icl-rocketry/daq-hardware/BOM DAQ.xlsx

Id | Designator | Package | Quantity | Designation | Digikey Part Nr | Unit Pricing | url | Total Price
1 | C32,C13,C11,C1,C10,C7 | C_0603_1608Metric | 6 | 100n | 1276-1000-1-ND | £0.02 | https://www.digikey.com/product-detail/en/samsung-electro-mechanics/CL10B104KB8NNNC/1276-1000-1-ND/3889086 | £0.12
2 | J40,J39,J18,J17,J16 | JST_XH_B3B-XH-A_1x03_P2.50mm_Vertical | 5 | Conn_01x03 | 455-2248-ND | £0.15 | https://www.digikey.com/product-detail/en/jst-sales-america-inc/B3B-XH-A-LF-SN/455-2248-ND/1651046 | £0.75
3 | R40,R38,R35,R33,R31,R3 | R_0603_1608Metric | 6 | 43k | 311-43.0KHRCT-ND | £0.10 | https://www.digikey.com/product-detail/en/yageo/RC0603FR-0743KL/311-43.0KHRCT-ND/730180 | £0.60
4 | R39,R37,R34,R32,R30,R2 | R_0603_1608Metric | 6 | 22k | A129704CT-ND | £0.10 | https://www.digikey.com/product-detail/en/te-connectivity-passive-product/CRGCQ0603F22K/A129704CT-ND/8577536 | £0.60
6 | D2,D1,D8,D3,D7 | LED_0603_1608Metric_Castellated | 3 | LED | SML-D12U1WT86CT-ND | £0.12 | https://www.digikey.co.uk/product-detail/en/rohm-semiconductor/SML-D12U1WT86/SML-D12U1WT86CT-ND/5843858 | £0.36
7 | R36,R29,R10,R9,R8,R7,R25 | R_0603_1608Metric | 7 | 470 | A129684CT-ND | £0.10 | https://www.digikey.com/product-detail/en/te-connectivity-passive-product/CRGCQ0603F470R/A129684CT-ND/8577516 | £0.70
9 | SW3 | SW_CuK_JS202011AQN_DPDT_Angled | 1 | SW_DPDT_x2 | 401-2000-ND | £0.43 | https://www.digikey.com/products/en?keywords=JS202011AQN | £0.43
10 | C31,C30,C29,C14,C12,C5,C4 | CP_Elec_4x5.4 | 7 | 10u | 399-14794-1-ND | £0.13 | https://www.digikey.co.uk/product-detail/en/kemet/EDK106M035A9BAA/399-14794-1-ND/7319832 | £0.88
12 | C27 | C_0603_1608Metric_Pad1.05x0.95mm_HandSolder | 1 | 220nF | 1276-1989-1-ND | £0.03 | https://www.digikey.co.uk/product-detail/en/tdk-corporation/C1608X7R1A224M/445-5133-1-ND/2093748 | £0.03
13 | R20,R19,R12,R15,R14,R13,R11,R28,R17,R5,R4 | R_0603_1608Metric | 11 | 10k | A129700CT-ND | £0.02 | https://www.digikey.com/product-detail/en/te-connectivity-passive-product/CRGCQ0603F10K/A129700CT-ND/8577532 | £0.26
14 | U4 | Texas_PowerVFQFN_15 | 1 | TPS63070 | 296-44874-1-ND | £2.08 | https://www.digikey.com/product-detail/en/texas-instruments/TPS63070RNMR/296-44874-1-ND/6217416 | £2.08
15 | R24 | R_0603_1608Metric | 1 | 150k | A129714CT-ND | £0.10 | https://www.digikey.com/product-detail/en/te-connectivity-passive-product/CRGCQ0603F150K/A129714CT-ND/8577546 | £0.10
16 | R23 | R_0603_1608Metric | 1 | 470k | A129720CT-ND | £0.10 | https://www.digikey.com/product-detail/en/te-connectivity-passive-product/CRGCQ0603F470K/A129720CT-ND/8577552 | £0.10
17 | U5 | Texas_PowerVFQFN_15 | 1 | TPS630701 | 296-47298-1-ND | £2.08 | https://www.digikey.com/product-detail/en/texas-instruments/TPS630701RNMR/296-47298-1-ND/7688308 | £2.08
18 | R22,R21 | R_0603_1608Metric | 2 | 100k | A129712CT-ND | £0.10 | https://www.digikey.com/product-detail/en/te-connectivity-passive-product/CRGCQ0603F100K/A129712CT-ND/8577544 | £0.20
19 | L3,L2 | L_Taiyo-Yuden_NR-30xx | 2 | 1u5 | 587-2617-1-ND | £0.41 | https://www.digikey.com/product-detail/en/taiyo-yuden/NR3015T1R5N/587-2617-1-ND/2349988 | £0.82
22 | R6,R1 | R_0603_1608Metric | 2 | 4k7 | A129696CT-ND | £0.02 | https://www.digikey.com/product-detail/en/te-connectivity-passive-product/CRGCQ0603F4K7/A129696CT-ND/8577528 | £0.05
24 | U12 | TSSOP-28_4.4x9.7mm_P0.65mm | 1 | PCA9685PW | 568-11925-1-ND | £1.81 | https://www.digikey.com/product-detail/en/nxp-usa-inc/PCA9685PW118/568-11925-1-ND/5221902 | £1.81
25 | U2 | ESP32-WROOM-32U | 1 | ESP32-WROOM-32D | 1904-1026-1-ND | £2.95 | https://www.digikey.com/product-detail/en/espressif-systems/ESP32-WROOM-32U/1904-1026-1-ND/9381735 | £2.95
26 | SW2,SW1 | SW_Push_1P1T_NO_CK_KMR2 | 2 | SW1 | 401-1426-1-ND | £0.40 | https://www.digikey.com/product-detail/en/c-k/K12SCS1.55NOLFTX/CKN10790CT-ND/7056072 | £0.80
29 | C3,C2 | C_0603_1608Metric | 2 | 1nF | 732-8001-1-ND | £0.01 | https://www.digikey.com/product-detail/en/w-rth-elektronik/885012206083/732-8001-1-ND/5454628 | £0.03
30 | D4,D6,D5 | D_SOD-123F | 3 | D_Schottky | 1655-1926-1-ND | £0.12 | https://www.digikey.co.uk/product-detail/en/smc-diode-solutions/DSS13UTR/1655-1926-1-ND/8341868 | £0.36
31 | Q3,Q2 | SOT-23 | 2 | PMV20ENR | 1727-2301-1-ND | £0.30 | https://www.digikey.com/products/en/discrete-semiconductor-products/transistors-fets-mosfets-single/278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 | £0.60
32 | C28 | C_0603_1608Metric | 1 | 2.2n | 732-8003-1-ND | £0.02 | https://www.digikey.com/product-detail/en/w-rth-elektronik/885012206085/732-8003-1-ND/5454630 | £0.02
33 | U13 | TSSOP-8_4.4x3mm_P0.65mm | 1 | TPS2412PW | 296-39371-1-ND | £2.24 | https://www.digikey.com/products/en/integrated-circuits-ics/pmic-or-controllers-ideal-diodes/758?k=TPS2412PW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 | £2.24
34 | J15 | BarrelJack_Wuerth_6941xx301002 | 1 | Barrel_Jack_Switch | 732-5930-ND | £0.80 | https://www.digikey.co.uk/product-detail/en/w-rth-elektronik/694106301002/732-5930-ND/5047522 | £0.80
35 | J1 | USB_B_OST_USB-B1HSxx_Horizontal | 1 | USB_B | ED2983-ND | £0.45 | https://www.digikey.co.uk/product-detail/en/on-shore-technology-inc/USB-B1HSB6/ED2983-ND/2677744 | £0.45
42 | C15,C19,C17,C21 | C_0603_1608Metric | 4 | 100nF | 1276-1000-1-ND | £0.02 | https://www.digikey.com/product-detail/en/samsung-electro-mechanics/CL10B104KB8NNNC/1276-1000-1-ND/3889086 | £0.08
43 | J2 | microSD_HC_Hirose_DM3AT-SF-PEJM5 | 1 | Micro_SD_Card_Det_Hirose_DM3AT | HR1964CT-ND | £2.08 | https://www.digikey.com/product-detail/en/hirose-electric-co-ltd/DM3AT-SF-PEJM5/HR1964CT-ND/2533566 | £2.08
44 | U1 | QFN-24-1EP_4x4mm_P0.5mm_EP2.6x2.6mm_ThermalVias | 1 | CP2102N-A01-GQFN24 | 336-4737-1-ND | £1.05 | https://www.digikey.com/products/en/integrated-circuits-ics/interface-controllers/753?k=CP2102N-A01-GQFN24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 | £1.05
45 | U11 | TSSOP-20_4.4x6.5mm_Pitch0.65mm | 1 | ADS131M04 | 296-ADS131M04IPWRCT-ND | £4.20 | https://www.digikey.co.uk/product-detail/en/texas-instruments/ADS131M04IPWR/296-ADS131M04IPWRCT-ND/10817002 | £4.20
46 | U3 | Texas_S-PWSON-N10_ThermalVias | 1 | TPS61093 | 296-39430-1-ND | £2.08 | https://www.digikey.com/product-detail/en/texas-instruments/TPS61093DSKR/296-39430-1-ND/5143378 | £2.08
47 | R18 | R_0603_1608Metric | 1 | 200k | P200KHCT-ND | £0.05 | https://www.digikey.com/product-detail/en/panasonic-electronic-components/ERJ-3EKF2003V/P200KHCT-ND/198241 | £0.05
48 | R16 | R_0603_1608Metric | 1 | 191k | P191KHCT-ND | £0.05 | https://www.digikey.com/product-detail/en/panasonic-electronic-components/ERJ-3EKF1913V/P191KHCT-ND/198216 | £0.05
49 | L1 | L_Taiyo-Yuden_NR-30xx | 1 | 10u | 587-1650-1-ND | £0.27 | https://www.digikey.com/product-detail/en/taiyo-yuden/NR3015T100M/587-1650-1-ND/1008265 | £0.27
50 | C26,C25,C24,C23,C22,C20,C18,C16 | C_0603_1608Metric | 8 | 10nF | 732-8007-1-ND | £0.02 | https://www.digikey.com/product-detail/en/w-rth-elektronik/885012206089/732-8007-1-ND/5454634 | £0.13
51 | C9,C8 | C_0603_1608Metric | 2 | 1u | 1276-1036-1-ND | £0.03 | https://www.digikey.com/product-detail/en/samsung-electro-mechanics/CL10A105KQ8NNNC/1276-1036-1-ND/3889122 | £0.05
52 | C6 | C_0603_1608Metric | 1 | 4u7 | 1276-1045-1-ND | £0.04 | https://www.digikey.com/product-detail/en/samsung-electro-mechanics/CL10A475KQ8NNNC/1276-1045-1-ND/3889131 | £0.04
53 | U10 | SMDIP-4_W9.53mm | 1 | LTV-817S | 160-1893-1-ND | £0.38 | https://www.digikey.com/product-detail/en/lite-on-inc/LTV-817S-TA1/160-1893-1-ND/3306757 | £0.38
54 | R27,R26 | R_0603_1608Metric | 2 | 500 | P499HCT-ND | £0.05 | https://www.digikey.com/product-detail/en/panasonic-electronic-components/ERJ-3EKF4990V/P499HCT-ND/198414 | £0.10
55 | J10,J9,J14,J13,J12,J11,J5,J6,J7,J8,J37,J36,J4 | TerminalBlock_Phoenix_MPT-0,5-2-2.54_1x02_P2.54mm_Horizontal | 13 | Screw_Terminal_01x02 | ED10561-ND | £0.44 | https://www.digikey.com/product-detail/en/on-shore-technology-inc/OSTVN02A150/ED10561-ND/1588862 | £5.75
57 | J3 | JST_PH_S2B-PH-K_1x02_P2.00mm_Horizontal | 1 | Conn_01x02 | 455-1719-ND | £0.13 | https://www.digikey.co.uk/product-detail/en/jst-sales-america-inc/S2B-PH-K-S-LF-SN/455-1719-ND/926626 | £0.13
58 | U9,U8,U7,U6 | SOIC-8_3.9x4.9mm_P1.27mm | 4 | MAX31855RASA | MAX31855RASA+TCT-ND | £4.06 | https://www.digikey.com/products/en/integrated-circuits-ics/interface-sensor-and-detector-interfaces/752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 | £16.24
59 | Q1 | SOT-363_SC-70-6 | 1 | MMDT2222A | MMDT2222A-FDICT-ND | £0.26 | https://www.digikey.com/product-detail/en/diodes-incorporated/MMDT2222A-7-F/MMDT2222A-FDICT-ND/717897 | £0.26
 |  |  |  |  |  |  |  | £53.15
 | notes:
 | qty when searching: 10 for capacitors, 1 for everything else
 | get cut tape, NOT reels
 | passives 0603imp and 1608 metric
 | if all else equal Samsung electro-mechanics >>
 | passives = resistors, capacitors
