icl-rocketry/daq-hardware/daq-hardware.kicad_pcb

## KiCad design daq-hardware.kicad_pcb (2019-11-12)

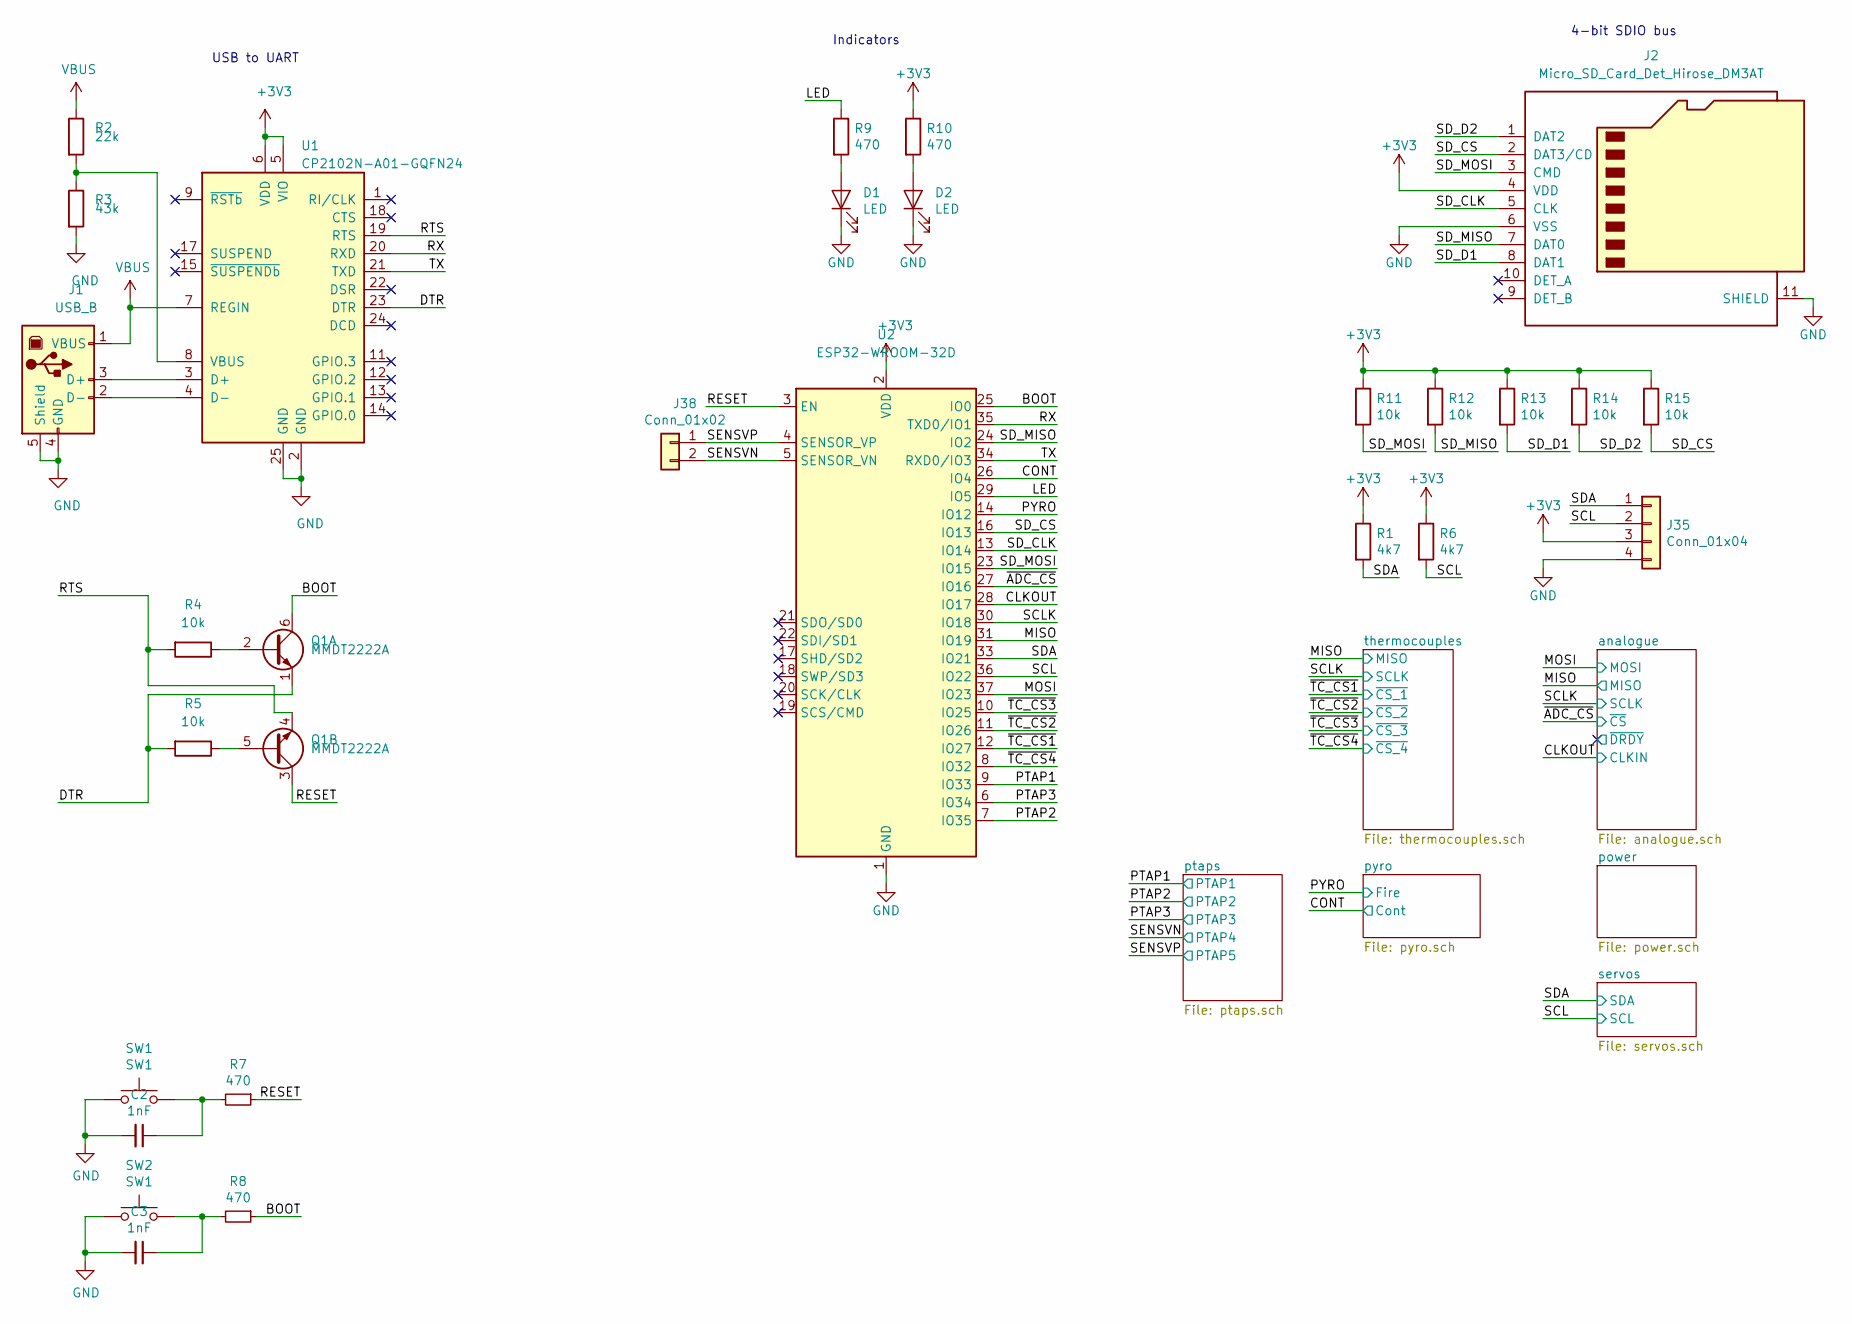
[picture p1: schematic daq-hardware.sch]

Parts:
C2, C3: 1nF; C_0603_1608Metric
D1, D2: LED; LED_0603_1608Metric_Castellated
J1: USB_B; USB_B_OST_USB-B1HSxx_Horizontal
J2: Micro_SD_Card_Det_Hirose_DM3AT; microSD_HC_Hirose_DM3AT-SF-PEJM5
J35: Conn_01x04; PinHeader_1x04_P2.54mm_Vertical
J38: Conn_01x02; PinHeader_1x02_P2.54mm_Vertical
Q1: MMDT2222A; SOT-363_SC-70-6
R1, R6: 4k7; R_0603_1608Metric
R2: 22k; R_0603_1608Metric
R3: 43k; R_0603_1608Metric
R4, R5, R11, R12, R13, R14, R15: 10k; R_0603_1608Metric
R7, R8, R9, R10: 470; R_0603_1608Metric
SW1, SW2: SW1; SW_Push_1P1T_NO_CK_KMR2
U1: CP2102N-A01-GQFN24; QFN-24-1EP_4x4mm_P0.5mm_EP2.6x2.6mm_ThermalVias
U2: ESP32-WROOM-32D; ESP32-WROOM-32U

Connections:
+3V3: J2.4 (VDD), J35.3, R1.1, R6.1, R10.1, R11.1, R12.1, R13.1, R14.1, R15.1, U1.5 (VIO), U1.6 (VDD), U2.2 (VDD); also elsewhere on the board
/BOOT: Q1.6 (C1), R8.1, U2.25 (IO0); also elsewhere on the board
/CLKOUT: U2.28 (IO17); also elsewhere on the board
/CONT: U2.26 (IO4); also elsewhere on the board
/DTR: Q1.1 (E1), R5.2, U1.23 (DTR)
/LED: R9.1, U2.29 (IO5); also elsewhere on the board
/MISO: U2.31 (IO19); also elsewhere on the board
/MOSI: U2.37 (IO23); also elsewhere on the board
/PTAP1: U2.9 (IO33); also elsewhere on the board
/PTAP2: U2.7 (IO35); also elsewhere on the board
/PTAP3: U2.6 (IO34); also elsewhere on the board
/PYRO: U2.14 (IO12); also elsewhere on the board
/RESET: Q1.3 (C2), R7.1, U2.3 (EN); also elsewhere on the board
/RTS: Q1.4 (E2), R4.2, U1.19 (RTS)
/RX: U1.20 (RXD), U2.35 (TXD0/IO1); also elsewhere on the board
/SCL: J35.2, R6.2, U2.36 (IO22); also elsewhere on the board
/SCLK: U2.30 (IO18); also elsewhere on the board
/SDA: J35.1, R1.2, U2.33 (IO21); also elsewhere on the board
/SD_CLK: J2.5 (CLK), U2.13 (IO14); also elsewhere on the board
/SD_CS: J2.2 (DAT3/CD), R15.2, U2.16 (IO13); also elsewhere on the board
/SD_D1: J2.8 (DAT1), R13.2
/SD_D2: J2.1 (DAT2), R14.2
/SD_MISO: J2.7 (DAT0), R12.2, U2.24 (IO2); also elsewhere on the board
/SD_MOSI: J2.3 (CMD), R11.2, U2.23 (IO15); also elsewhere on the board
/SENSVN: J38.2, U2.5 (SENSOR_VN); also elsewhere on the board
/SENSVP: J38.1, U2.4 (SENSOR_VP); also elsewhere on the board
/TX: U1.21 (TXD), U2.34 (RXD0/IO3); also elsewhere on the board
/~ADC_CS: U2.27 (IO16); also elsewhere on the board
/~TC_CS1: U2.12 (IO27); also elsewhere on the board
/~TC_CS2: U2.11 (IO26); also elsewhere on the board
/~TC_CS3: U2.10 (IO25); also elsewhere on the board
/~TC_CS4: U2.8 (IO32); also elsewhere on the board
GND: C2.2, C3.2, D1.1 (K), D2.1 (K), J1.4 (GND), J1.5 (Shield), J2.6 (VSS), J2.11 (SHIELD), J35.4, R3.2, SW1.1, SW2.1, U1.2 (GND), U1.25 (GND), U2.1 (GND), U2.15 (GND), U2.38 (GND); also elsewhere on the board
unnamed: C2.1, R7.2, SW1.2
unnamed: C3.1, R8.2, SW2.2
unnamed: D1.2 (A), R9.2
unnamed: D2.2 (A), R10.2
unnamed: J1.2 (D-), U1.4 (D-)
unnamed: J1.3 (D+), U1.3 (D+)
unnamed: Q1.2 (B1), R4.1
unnamed: Q1.5 (B2), R5.1
unnamed: R2.2, R3.1, U1.8 (VBUS)
unnamed 113: U2.17 (SHD/SD2); also elsewhere on the board
unnamed 114: U2.18 (SWP/SD3); also elsewhere on the board
unnamed 115: U2.19 (SCS/CMD); also elsewhere on the board
unnamed 116: U2.20 (SCK/CLK); also elsewhere on the board
unnamed 117: U2.21 (SDO/SD0); also elsewhere on the board
unnamed 118: U2.22 (SDI/SD1); also elsewhere on the board
unnamed 119: U2.32 (NC); also elsewhere on the board
VBUS: J1.1 (VBUS), R2.1, U1.7 (REGIN); also elsewhere on the board

Notes on the sheet:
4-bit SDIO bus
USB to UART
Indicators

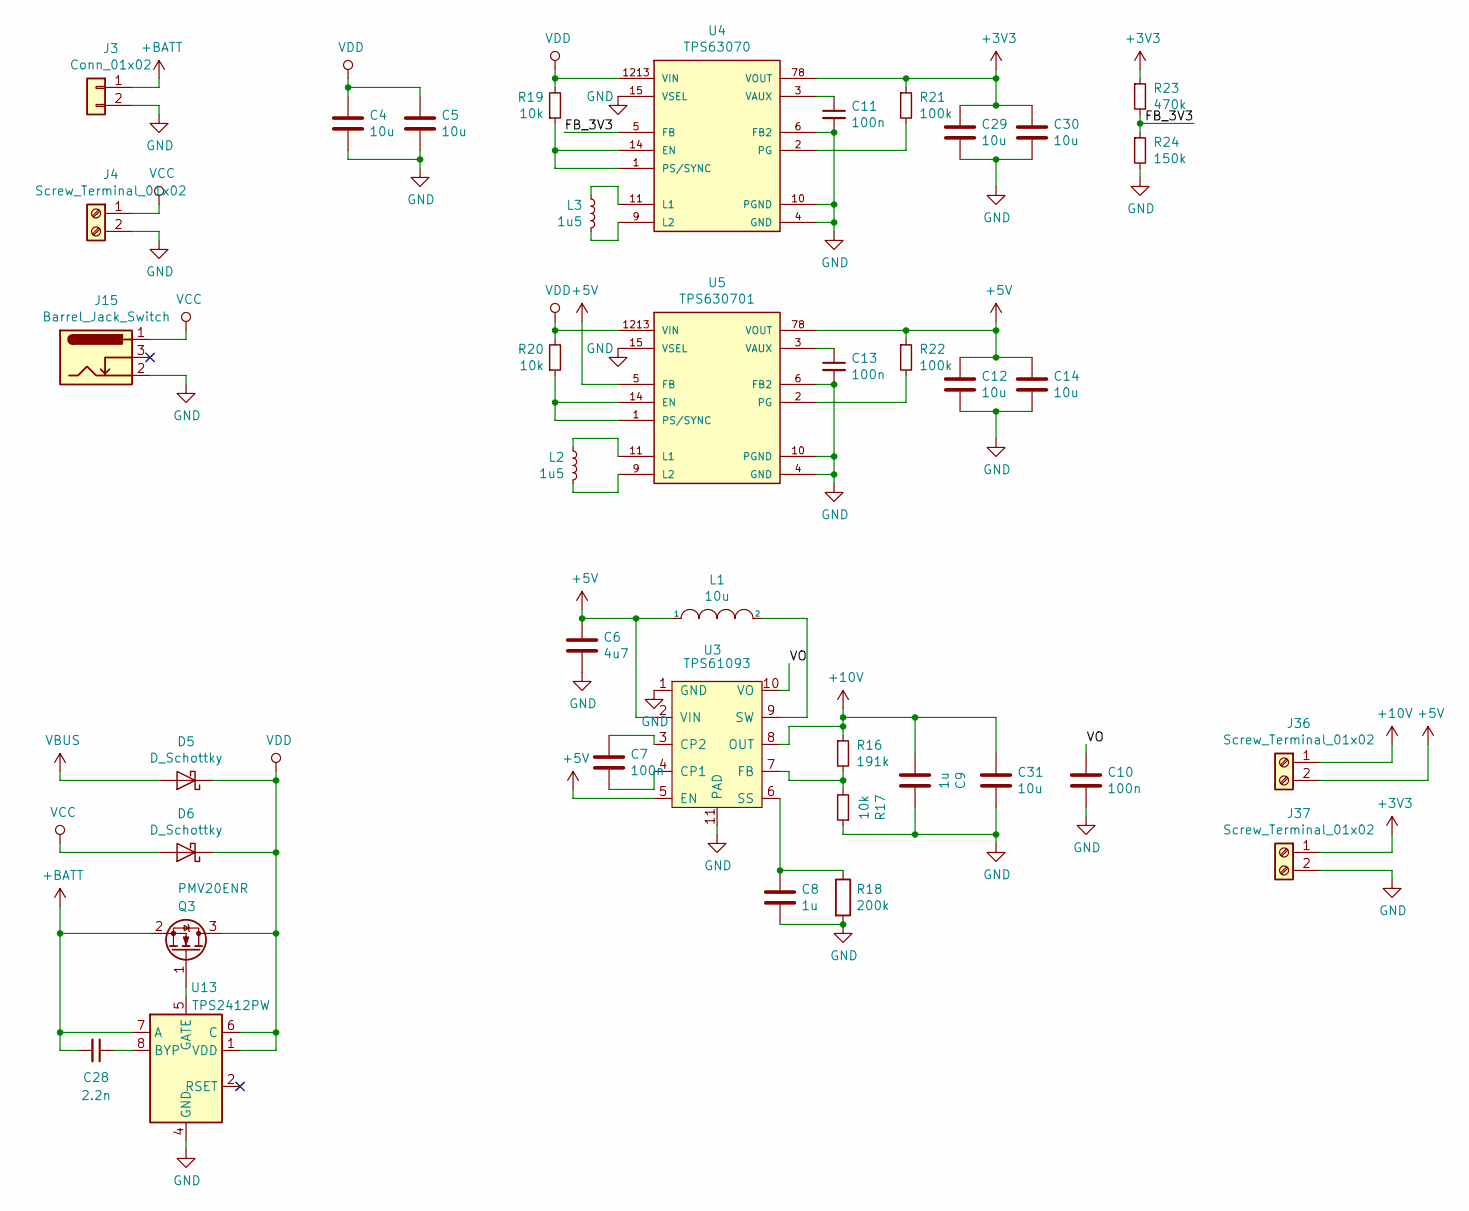
[picture p2: schematic power.sch]

Parts:
C4, C5, C12, C14, C29, C30, C31: 10u; CP_Elec_4x5.4
C6: 4u7; C_0603_1608Metric
C7, C10, C11, C13: 100n; C_0603_1608Metric
C8, C9: 1u; C_0603_1608Metric
C28: 2.2n; C_0603_1608Metric
D5, D6: D_Schottky; D_SOD-123F
J3: Conn_01x02; JST_PH_S2B-PH-K_1x02_P2.00mm_Horizontal
J4, J36, J37: Screw_Terminal_01x02; TerminalBlock_Phoenix_MPT-2.54mm_2pol
J15: Barrel_Jack_Switch; BarrelJack_Wuerth_6941xx301002
L1: 10u; L_Taiyo-Yuden_NR-30xx
L2, L3: 1u5; L_Taiyo-Yuden_NR-30xx
Q3: PMV20ENR; SOT-23
R16: 191k; R_0603_1608Metric
R17, R19, R20: 10k; R_0603_1608Metric
R18: 200k; R_0603_1608Metric
R21, R22: 100k; R_0603_1608Metric
R23: 470k; R_0603_1608Metric
R24: 150k; R_0603_1608Metric
U3: TPS61093; Texas_S-PWSON-N10_ThermalVias
U4: TPS63070; Texas_PowerVFQFN_15
U5: TPS630701; Texas_PowerVFQFN_15
U13: TPS2412PW; TSSOP-8_4.4x3mm_P0.65mm

Connections:
+3V3: C29.1, C30.1, J37.1, R21.1, R23.1, U4.78 (VOUT); also elsewhere on the board
+5V: C6.1, C12.1, C14.1, J36.2, L1.1, R22.1, U3.2 (VIN), U3.5 (EN), U5.5 (FB), U5.78 (VOUT); also elsewhere on the board
+10V: C9.2, C31.1, J36.1, R16.1, U3.8 (OUT)
+BATT: C28.2, J3.1, Q3.2 (S), U13.7 (A)
/power/FB_3V3: R23.2, R24.1, U4.5 (FB)
/power/VO: C10.1, U3.10 (VO)
GND: C4.2, C5.2, C6.2, C8.2, C9.1, C10.2, C11.2, C12.2, C13.2, C14.2, C29.2, C30.2, C31.2, J3.2, J4.2, J15.2, J37.2, R17.1, R18.2, R24.2, U3.1 (GND), U3.11 (PAD), U4.4 (GND), U4.6 (FB2), U4.10 (PGND), U4.15 (VSEL), U5.4 (GND), U5.6 (FB2), U5.10 (PGND), U5.15 (VSEL), U13.3 (GND), U13.4 (GND); also elsewhere on the board
unnamed: C7.1, U3.3 (CP2)
unnamed: C7.2, U3.4 (CP1)
unnamed: C8.1, R18.1, U3.6 (SS)
unnamed: C11.1, U4.3 (VAUX)
unnamed: C13.1, U5.3 (VAUX)
unnamed: C28.1, U13.8 (BYP)
unnamed: L1.2, U3.9 (SW)
unnamed: L2.1, U5.9 (L2)
unnamed: L2.2, U5.11 (L1)
unnamed: L3.1, U4.9 (L2)
unnamed: L3.2, U4.11 (L1)
unnamed: Q3.1 (G), U13.5 (GATE)
unnamed: R16.2, R17.2, U3.7 (FB)
unnamed: R19.1, U4.1 (PS/SYNC), U4.14 (EN)
unnamed: R20.1, U5.1 (PS/SYNC), U5.14 (EN)
unnamed: R21.2, U4.2 (PG)
unnamed: R22.2, U5.2 (PG)
VBUS: D5.2 (A); also elsewhere on the board
VCC: D6.2 (A), J4.1, J15.1
VDD: C4.1, C5.1, D5.1 (K), D6.1 (K), Q3.3 (D), R19.2, R20.2, U4.1213 (VIN), U5.1213 (VIN), U13.1 (VDD), U13.6 (C)

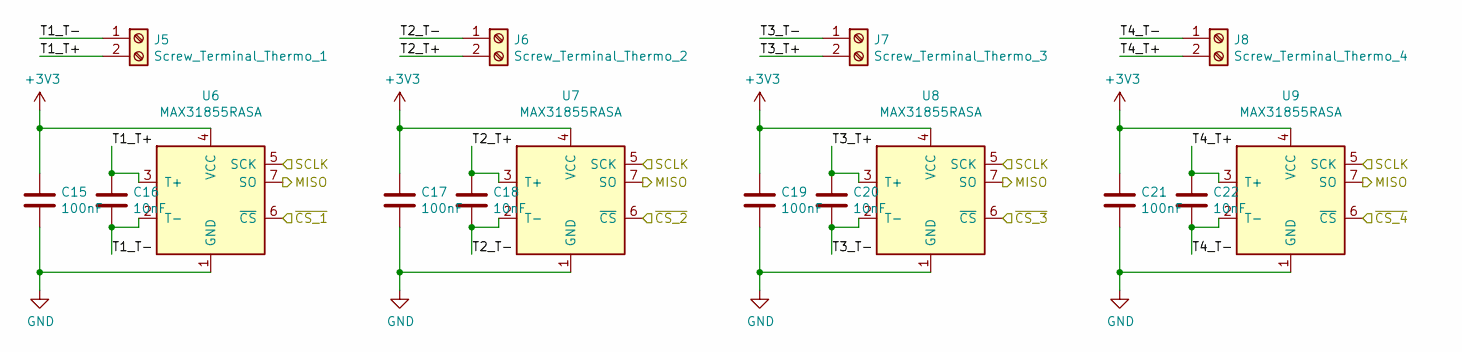
[picture p3: schematic thermocouples.sch]

Parts:
C15, C17, C19, C21: 100nF; C_0603_1608Metric
C16, C18, C20, C22: 10nF; C_0603_1608Metric
J5: Screw_Terminal_Thermo_1; TerminalBlock_Phoenix_MPT-2.54mm_2pol
J6: Screw_Terminal_Thermo_2; TerminalBlock_Phoenix_MPT-2.54mm_2pol
J7: Screw_Terminal_Thermo_3; TerminalBlock_Phoenix_MPT-2.54mm_2pol
J8: Screw_Terminal_Thermo_4; TerminalBlock_Phoenix_MPT-2.54mm_2pol
U6, U7, U8, U9: MAX31855RASA; SOIC-8_3.9x4.9mm_P1.27mm

Connections:
+3V3: C15.1, C17.1, C19.1, C21.1, U6.4 (VCC), U7.4 (VCC), U8.4 (VCC), U9.4 (VCC); also elsewhere on the board
/MISO: U6.7 (SO), U7.7 (SO), U8.7 (SO), U9.7 (SO); also elsewhere on the board
/SCLK: U6.5 (SCK), U7.5 (SCK), U8.5 (SCK), U9.5 (SCK); also elsewhere on the board
/thermocouples/T1_T+: C16.1, J5.2, U6.3 (T+)
/thermocouples/T1_T-: C16.2, J5.1, U6.2 (T-)
/thermocouples/T2_T+: C18.1, J6.2, U7.3 (T+)
/thermocouples/T2_T-: C18.2, J6.1, U7.2 (T-)
/thermocouples/T3_T+: C20.1, J7.2, U8.3 (T+)
/thermocouples/T3_T-: C20.2, J7.1, U8.2 (T-)
/thermocouples/T4_T+: C22.1, J8.2, U9.3 (T+)
/thermocouples/T4_T-: C22.2, J8.1, U9.2 (T-)
/~TC_CS1: U6.6 (~CS~); also elsewhere on the board
/~TC_CS2: U7.6 (~CS~); also elsewhere on the board
/~TC_CS3: U8.6 (~CS~); also elsewhere on the board
/~TC_CS4: U9.6 (~CS~); also elsewhere on the board
GND: C15.2, C17.2, C19.2, C21.2, U6.1 (GND), U7.1 (GND), U8.1 (GND), U9.1 (GND); also elsewhere on the board

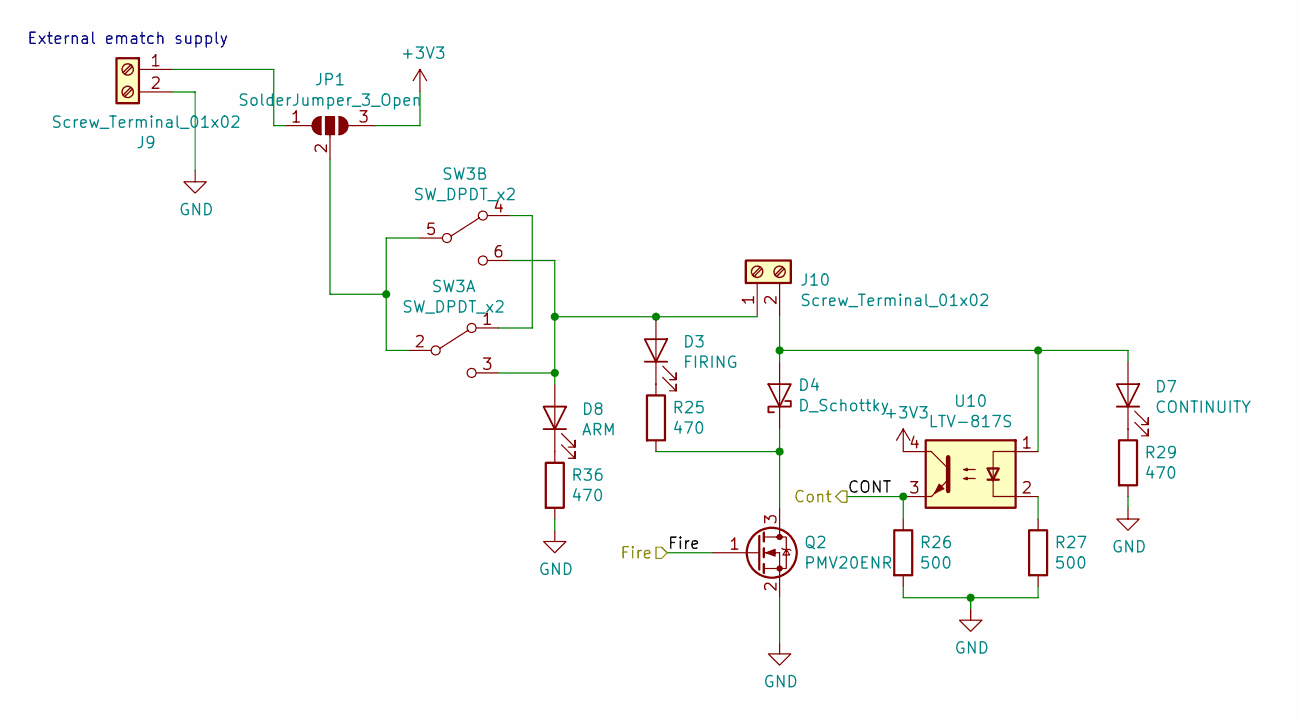
[picture p4: schematic pyro.sch]

Parts:
D3: FIRING; LED_0603_1608Metric_Castellated
D4: D_Schottky; D_SOD-123F
D7: CONTINUITY; LED_0603_1608Metric_Castellated
D8: ARM; LED_0603_1608Metric_Castellated
J9, J10: Screw_Terminal_01x02; TerminalBlock_Phoenix_MPT-0,5-2-2.54_1x02_P2.54mm_Horizontal
JP1: SolderJumper_3_Open; SolderJumper-3_P1.3mm_Open_RoundedPad1.0x1.5mm_NumberLabels
Q2: PMV20ENR; SOT-23
R25, R29, R36: 470; R_0603_1608Metric
R26, R27: 500; R_0603_1608Metric
SW3: SW_DPDT_x2; SW_CuK_JS202011AQN_DPDT_Angled
U10: LTV-817S; SMDIP-4_W9.53mm

Connections:
+3V3: JP1.3 (B), U10.4; also elsewhere on the board
/CONT: R26.1, U10.3; also elsewhere on the board
/PYRO: Q2.1 (G); also elsewhere on the board
GND: J9.2, Q2.2 (S), R26.2, R27.2, R29.2, R36.2; also elsewhere on the board
unnamed: D3.1 (K), R25.1
unnamed: D3.2 (A), D8.2 (A), J10.1, SW3.3 (C), SW3.6 (C)
unnamed: D4.1 (K), Q2.3 (D), R25.2
unnamed: D4.2 (A), D7.2 (A), J10.2, U10.1
unnamed: D7.1 (K), R29.1
unnamed: D8.1 (K), R36.1
unnamed: J9.1, JP1.1 (A)
unnamed: JP1.2 (C), SW3.2 (B), SW3.5 (B)
unnamed: R27.1, U10.2
unnamed: SW3.1 (A), SW3.4 (A)

Notes on the sheet:
External ematch supply

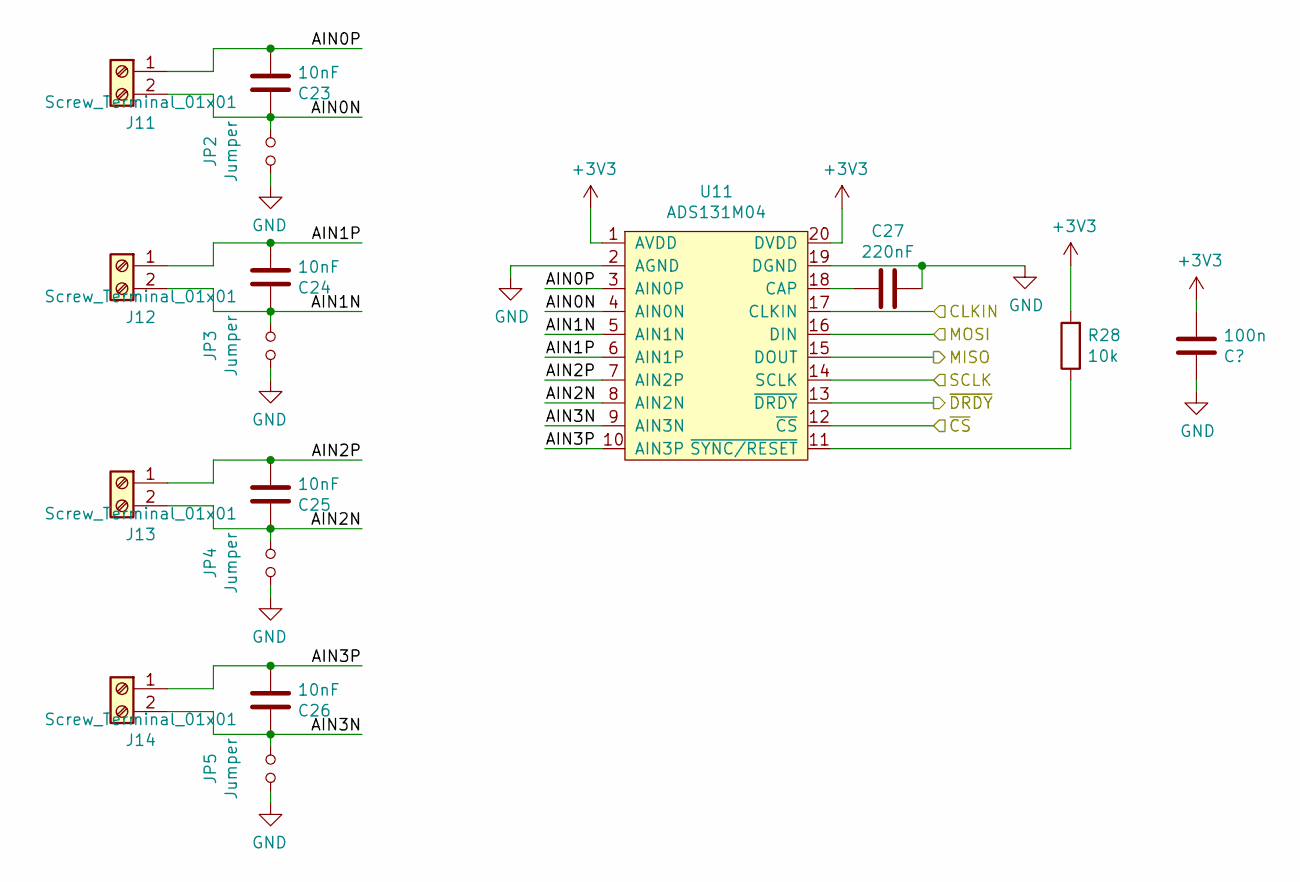
[picture p5: schematic analogue.sch]

Parts:
C23, C24, C25, C26: 10nF; C_0603_1608Metric
C27: 220nF; C_0603_1608Metric_Pad1.05x0.95mm_HandSolder
J11, J12, J13, J14: Screw_Terminal_01x01; TerminalBlock_Phoenix_MPT-2.54mm_2pol
JP2, JP3, JP4, JP5: Jumper; PinHeader_1x02_P2.54mm_Vertical
R28: 10k; R_0603_1608Metric
U11: ADS131M04; TSSOP-20_4.4x6.5mm_Pitch0.65mm

Connections:
+3V3: R28.2, U11.1 (AVDD), U11.20 (DVDD); also elsewhere on the board
/CLKOUT: U11.17 (CLKIN); also elsewhere on the board
/MISO: U11.15 (DOUT); also elsewhere on the board
/MOSI: U11.16 (DIN); also elsewhere on the board
/SCLK: U11.14 (SCLK); also elsewhere on the board
/analogue/AIN0N: C23.1, J11.2, JP2.1, U11.4 (AIN0N)
/analogue/AIN0P: C23.2, J11.1, U11.3 (AIN0P)
/analogue/AIN1N: C24.1, J12.2, JP3.1, U11.5 (AIN1N)
/analogue/AIN1P: C24.2, J12.1, U11.6 (AIN1P)
/analogue/AIN2N: C25.1, J13.2, JP4.1, U11.8 (AIN2N)
/analogue/AIN2P: C25.2, J13.1, U11.7 (AIN2P)
/analogue/AIN3N: C26.1, J14.2, JP5.1, U11.9 (AIN3N)
/analogue/AIN3P: C26.2, J14.1, U11.10 (AIN3P)
/~ADC_CS: U11.12 (~CS); also elsewhere on the board
GND: C27.1, JP2.2, JP3.2, JP4.2, JP5.2, U11.2 (AGND), U11.19 (DGND); also elsewhere on the board
unnamed: C27.2, U11.18 (CAP)
unnamed: R28.1, U11.11 (~SYNC/RESET)

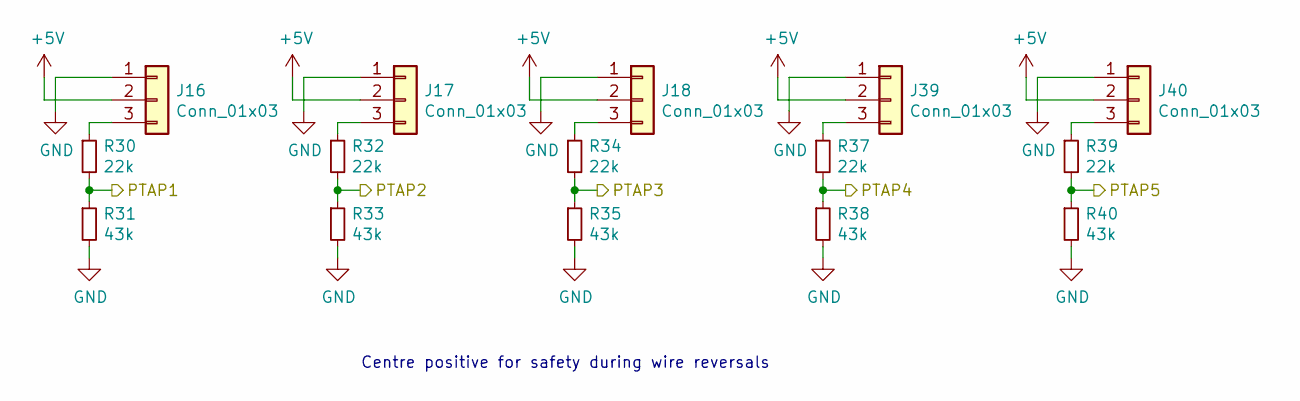
[picture p6: schematic ptaps.sch]

Parts:
J16, J17, J18, J39, J40: Conn_01x03; JST_XH_B3B-XH-A_1x03_P2.50mm_Vertical
R30, R32, R34, R37, R39: 22k; R_0603_1608Metric
R31, R33, R35, R38, R40: 43k; R_0603_1608Metric

Connections:
+5V: J16.2, J17.2, J18.2, J39.2, J40.2; also elsewhere on the board
/PTAP1: R30.2, R31.1; also elsewhere on the board
/PTAP2: R32.2, R33.1; also elsewhere on the board
/PTAP3: R34.2, R35.1; also elsewhere on the board
/SENSVN: R37.2, R38.1; also elsewhere on the board
/SENSVP: R39.2, R40.1; also elsewhere on the board
GND: J16.1, J17.1, J18.1, J39.1, J40.1, R31.2, R33.2, R35.2, R38.2, R40.2; also elsewhere on the board
unnamed: J16.3, R30.1
unnamed: J17.3, R32.1
unnamed: J18.3, R34.1
unnamed: J39.3, R37.1
unnamed: J40.3, R39.1

Notes on the sheet:
Centre positive for safety during wire reversals

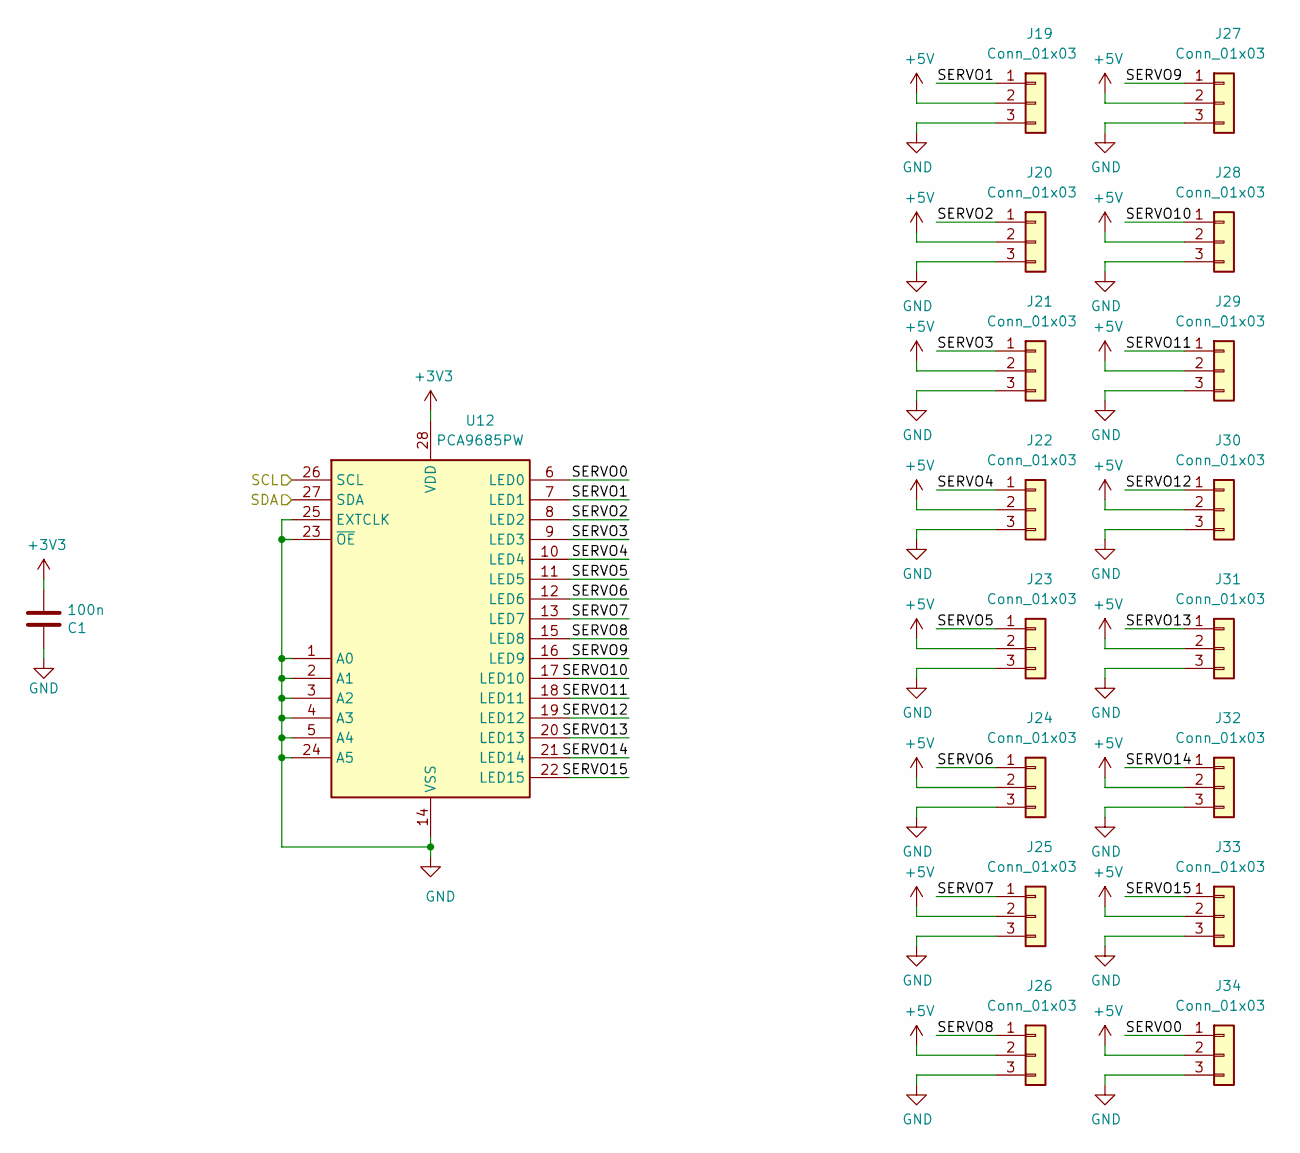
[picture p7: schematic servos.sch]

Parts:
C1: 100n; C_0603_1608Metric
J19, J20, J21, J22, J23, J24, J25, J26, J27, J28, J29, J30, J31, J32, J33, J34: Conn_01x03; PinHeader_1x03_P2.54mm_Vertical
U12: PCA9685PW; TSSOP-28_4.4x9.7mm_P0.65mm

Connections:
+3V3: C1.2, U12.28 (VDD); also elsewhere on the board
+5V: J19.2, J20.2, J21.2, J22.2, J23.2, J24.2, J25.2, J26.2, J27.2, J28.2, J29.2, J30.2, J31.2, J32.2, J33.2, J34.2; also elsewhere on the board
/SCL: U12.26 (SCL); also elsewhere on the board
/SDA: U12.27 (SDA); also elsewhere on the board
/servos/SERVO0: J34.1, U12.6 (LED0)
/servos/SERVO1: J19.1, U12.7 (LED1)
/servos/SERVO2: J20.1, U12.8 (LED2)
/servos/SERVO3: J21.1, U12.9 (LED3)
/servos/SERVO4: J22.1, U12.10 (LED4)
/servos/SERVO5: J23.1, U12.11 (LED5)
/servos/SERVO6: J24.1, U12.12 (LED6)
/servos/SERVO7: J25.1, U12.13 (LED7)
/servos/SERVO8: J26.1, U12.15 (LED8)
/servos/SERVO9: J27.1, U12.16 (LED9)
/servos/SERVO10: J28.1, U12.17 (LED10)
/servos/SERVO11: J29.1, U12.18 (LED11)
/servos/SERVO12: J30.1, U12.19 (LED12)
/servos/SERVO13: J31.1, U12.20 (LED13)
/servos/SERVO14: J32.1, U12.21 (LED14)
/servos/SERVO15: J33.1, U12.22 (LED15)
GND: C1.1, J19.3, J20.3, J21.3, J22.3, J23.3, J24.3, J25.3, J26.3, J27.3, J28.3, J29.3, J30.3, J31.3, J32.3, J33.3, J34.3, U12.1 (A0), U12.2 (A1), U12.3 (A2), U12.4 (A3), U12.5 (A4), U12.14 (VSS), U12.23 (~OE), U12.24 (A5), U12.25 (EXTCLK); also elsewhere on the board

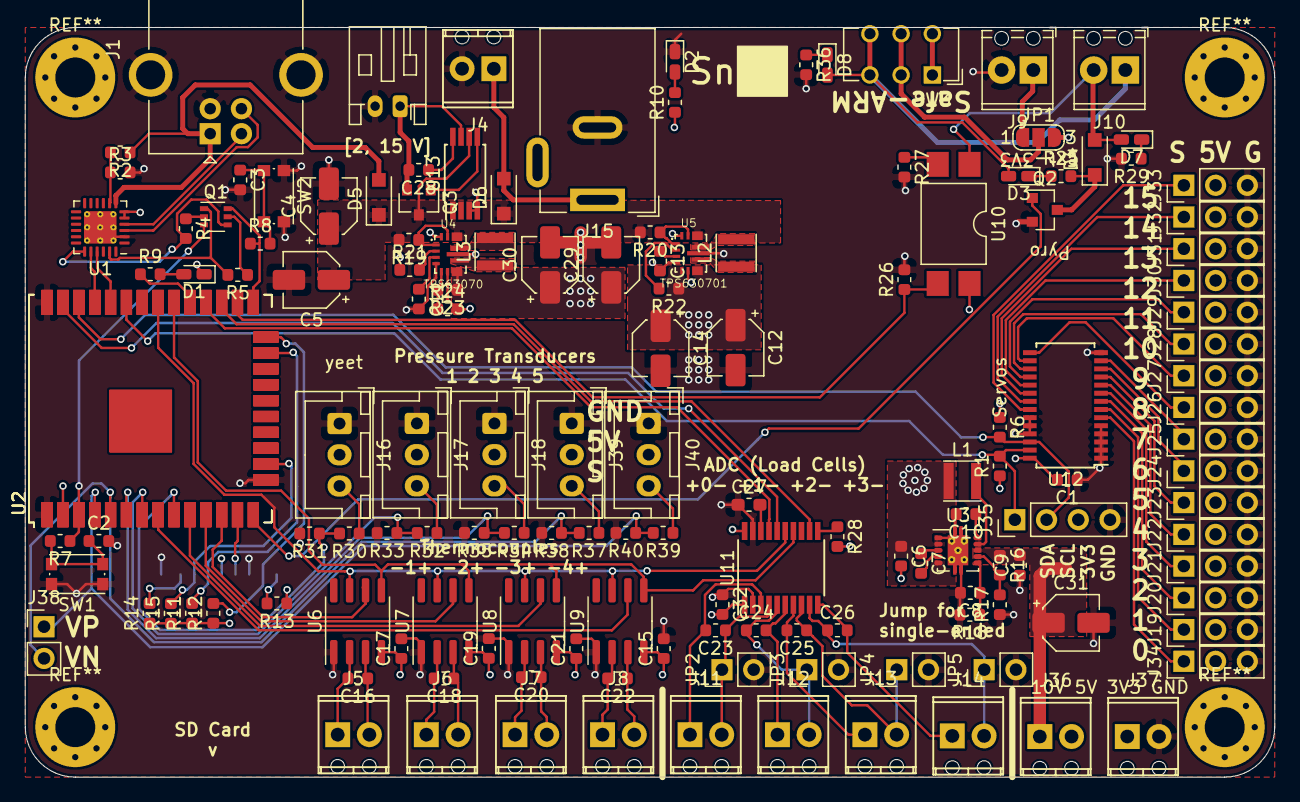
[picture p8: board daq-hardware.kicad_pcb from above]

Board: 4 copper layers, 100.0 x 60.0 mm, 149 parts (1 on the bottom side), 123 nets.

Other parts of the board:
C32: 100n; C_0603_1608Metric
U2#2, U2#3: ESP32-WROOM-32D; ESP32-WROOM-32U

Their connections:
+3V3: C32.2, U2#2.2, U2#3.2; also elsewhere on the board
/BOOT: U2#2.25, U2#3.25; also elsewhere on the board
/CLKOUT: U2#2.28, U2#3.28; also elsewhere on the board
/CONT: U2#2.26, U2#3.26; also elsewhere on the board
/LED: U2#2.29, U2#3.29; also elsewhere on the board
/MISO: U2#2.31, U2#3.31; also elsewhere on the board
/MOSI: U2#2.37, U2#3.37; also elsewhere on the board
/PTAP1: U2#2.9, U2#3.9; also elsewhere on the board
/PTAP2: U2#2.7, U2#3.7; also elsewhere on the board
/PTAP3: U2#2.6, U2#3.6; also elsewhere on the board
/PYRO: U2#2.14, U2#3.14; also elsewhere on the board
/RESET: U2#2.3, U2#3.3; also elsewhere on the board
/RX: U2#2.35, U2#3.35; also elsewhere on the board
/SCL: U2#2.36, U2#3.36; also elsewhere on the board
/SCLK: U2#2.30, U2#3.30; also elsewhere on the board
/SDA: U2#2.33, U2#3.33; also elsewhere on the board
/SD_CLK: U2#2.13, U2#3.13; also elsewhere on the board
/SD_CS: U2#2.16, U2#3.16; also elsewhere on the board
/SD_MISO: U2#2.24, U2#3.24; also elsewhere on the board
/SD_MOSI: U2#2.23, U2#3.23; also elsewhere on the board
/SENSVN: U2#2.5, U2#3.5; also elsewhere on the board
/SENSVP: U2#2.4, U2#3.4; also elsewhere on the board
/TX: U2#2.34, U2#3.34; also elsewhere on the board
/~ADC_CS: U2#2.27, U2#3.27; also elsewhere on the board
/~TC_CS1: U2#2.12, U2#3.12; also elsewhere on the board
/~TC_CS2: U2#2.11, U2#3.11; also elsewhere on the board
/~TC_CS3: U2#2.10, U2#3.10; also elsewhere on the board
/~TC_CS4: U2#2.8, U2#3.8; also elsewhere on the board
GND: C32.1, U2#2.1, U2#2.15, U2#2.38, U2#3.1, U2#3.15, U2#3.38; also elsewhere on the board
unnamed 113: U2#2.17, U2#3.17; also elsewhere on the board
unnamed 114: U2#2.18, U2#3.18; also elsewhere on the board
unnamed 115: U2#2.19, U2#3.19; also elsewhere on the board
unnamed 116: U2#2.20, U2#3.20; also elsewhere on the board
unnamed 117: U2#2.21, U2#3.21; also elsewhere on the board
unnamed 118: U2#2.22, U2#3.22; also elsewhere on the board
unnamed 119: U2#2.32, U2#3.32; also elsewhere on the board
