icl-rocketry/daq-hardware/(commit log)

2019-10-05 Fixed folder structure
    [daq-hardware.kicad_pcb, daq-hardware.sch]
2019-10-17 Added initial schematic
    [analogue.sch, daq-hardware.kicad_pcb, daq-hardware.sch]
2019-10-19 Created amps sheet
    [daq-hardware.kicad_pcb]
2019-10-19 Added thermocouples and amps sheet
    [amps.sch, daq-hardware.sch, thermocouples.sch]
2019-10-19 added reset and boot switches and barometer
    [daq-hardware.sch]
2019-10-19 Thermocouples
    Added heirarchial sheet for thermocouples and the schematics
    [analogue.sch, daq-hardware.sch]
2019-10-19 amplifier changes
    [daq-hardware.sch, thermocouples.sch]
2019-10-19 made ads1219 symbol
    [analogue.sch]
2019-10-19 added analog input pins to main file
    [analogue.sch, daq-hardware.sch]
2019-10-19 Thermocouples
    Added components to the PCB. Please check the GND and VCC lines arrangement for any changes.
    [daq-hardware.kicad_pcb, daq-hardware.sch, thermocouples.sch]
2019-10-19 Power supply implementation
    [power.sch]
2019-10-20 Fixed Main schem and removed baro
    [amps.sch, analogue.sch, daq-hardware.sch, power.sch, thermocouples.sch]
2019-10-22 Moved to iclr-hw library
    [daq-hardware.sch]
2019-10-22 added analog inputs to daq-hardware
    [analogue.sch, daq-hardware.sch]
2019-10-22 changed adc's resistance to 4k7
    [analogue.sch]
2019-10-25 Changed SD card from SPI to SDIO
    [daq-hardware.sch]
2019-10-25 Amended boot pin, moved i2c pullups to main schematic
    [analogue.sch, daq-hardware.sch]
2019-10-25 Added necessary SDIO pullups
    [daq-hardware.sch]
2019-10-25 Preliminary pin mapping and amended thermocouple hierarchical sheets
    [daq-hardware.sch, thermocouples.sch]
2019-10-25 Added and locked mounting holes
    [daq-hardware.kicad_pcb, daq-hardware.sch]
2019-10-25 Added indicator LEDs
    [daq-hardware.sch]
2019-10-26 Added 12v and 5v power supply
    [power.sch]
2019-10-26 Layout for Pyros
    [daq-hardware.kicad_pcb]
2019-10-26 Via Shielding
    [daq-hardware.kicad_pcb]
2019-10-26 Added 5v and 12v power supply
    [daq-hardware.sch]
2019-10-29 made the ads131m04 connections
    [analogue.sch]
2019-10-29 changed the hierarchical pins of the analogue
    [analogue.sch, daq-hardware.sch, power.sch]
2019-10-29 added inductors footprint
    [power.sch]
2019-10-30 Not sure if this is gonna overwrite stuff but I try to push this anyway
    [amps.sch, analogue.sch, daq-hardware.kicad_pcb, daq-hardware.sch, power.sch, pyro.sch, thermocouples.sch]
2019-10-30 Fixed conflicts, assigned all footprints.
    [analogue.sch, daq-hardware.kicad_pcb, daq-hardware.sch, power.sch, pyro.sch, thermocouples.sch]
2019-10-30 Cleaned up layout, added barrel jack for power input
    [analogue.sch, daq-hardware.kicad_pcb, daq-hardware.sch, power.sch, pyro.sch, thermocouples.sch]
2019-10-30 Laid out +3V3 section
    [daq-hardware.kicad_pcb, daq-hardware.sch, power.sch]
2019-10-31 Added 3D models, added ptaps sheet, fixed pyros
    [Fire.kicad_pcb, Fire.sch, analogue.sch, daq-hardware.kicad_pcb, daq-hardware.sch, power.sch, ptaps.sch, pyro.sch]
2019-10-31 Minor PCB rerouting
    [daq-hardware.kicad_pcb]
2019-11-02 layout changes
    [analogue.sch, daq-hardware.kicad_pcb]
2019-11-05 Add Copper
    [daq-hardware.kicad_pcb, power.sch]
2019-11-12 Release candidate
    [analogue.sch, daq-hardware.kicad_pcb, daq-hardware.sch, power.sch, ptaps.sch, pyro.sch, servos.sch, thermocouples.sch]
2019-11-12 Edward appeasement
    [analogue.sch, daq-hardware.kicad_pcb, daq-hardware.sch, ptaps.sch, pyro.sch]
2019-11-24 added BOM
    still not done
    [BOM DAQ.xlsx]
2019-12-09 Updated BOM
    [BOM DAQ.xlsx]
